dwolf0000001/telephone-exchange/Telefonkozpont_javitott.pdf

RL4
Q5

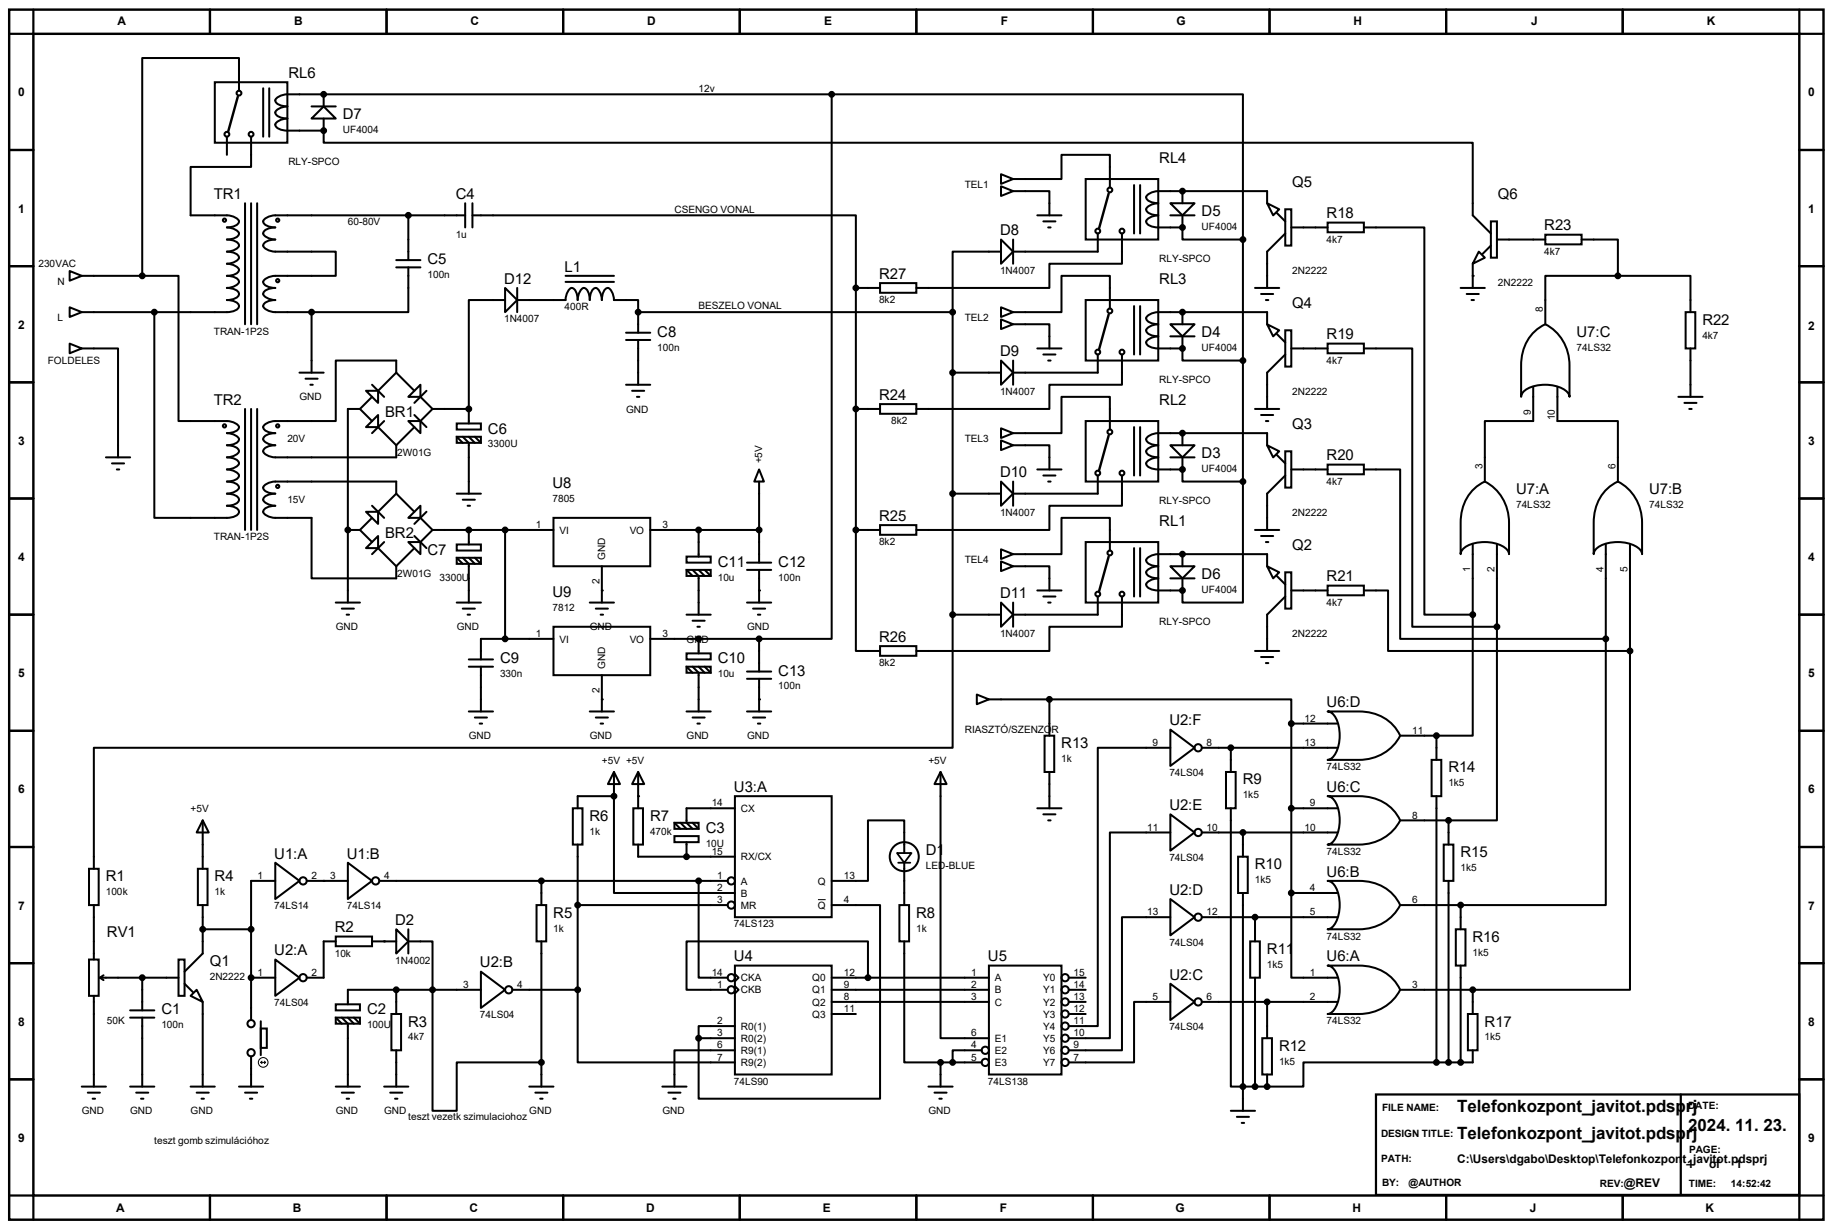
[picture p2: page 1]
