dwolf0000001/telephone-exchange/(list of files, drawings)

Other design files:
Telefonkozpont_javitot.pdsprj
